xmyoot/guarded-ph-acquisition-module/docs/architecture/06_sources.md

# Sources and evidence

Manufacturer documents were checked on 20 October 2026. PDFs successfully retrieved are stored in `../../datasheets/`; `sources.json` records their URLs and SHA-256 hashes. Text files beside the PDFs are reading aids generated by `pdftotext`, not replacements for package figures.

| Source | Revision reviewed | Design use |
|---|---|---|
| [TI LMP91200](https://www.ti.com/lit/ds/symlink/lmp91200.pdf) | SNAS571E, February 2016; package addendum October 2025 | p.3 pin table; pp.5–7 electrical limits; p.14 buffer blocks; pp.15–17 electrode connection, decoupling and guard layout |
| [TI ADS112C04](https://www.ti.com/lit/ds/symlink/ads112c04.pdf) | SBAS894A, October 2018; retrieved package addendum 2026 | p.3 PW pin table; pp.23–25 gain implementation, Eq.6/7, reference; p.35 address; pp.38–45 protocol/registers |
| [TI REF32xx / REF3220](https://www.ti.com/lit/gpn/REF3220) | SBVS058D, April 2026 | p.3 pin functions; pp.4–6 accuracy/headroom/enable; pp.11–12 slow startup; force/sense section |
| [TI TPS7A20](https://www.ti.com/lit/ds/symlink/tps7a20.pdf) | SBVS338H, July 2024 | p.4 DBV pin table; electrical/capacitance requirements; orderable addendum identifies TPS7A2033PDBVR as DBV SOT-23-5 |
| [TI TPS383x](https://www.ti.com/lit/ds/symlink/tps3839.pdf) | SBVS193D, July 2015 | DBZ SOT-23-3 pin table; K33 threshold/drive and reset delay |
| [TI ISO154x](https://www.ti.com/lit/ds/symlink/iso1540.pdf) | SLLSEB6F, December 2022 | Candidate isolated I²C architecture, side-specific low-level compatibility and independent supplies |
| [ADI ADuM5401 family](https://www.analog.com/media/en/technical-documentation/data-sheets/adum5401_5402_5403_5404.pdf) | Rev E, June 2020, accessed through web | Existing chip's isolated-power and directed digital-channel function |

ADuM5401 PDF local download timed out; its source was inspected on the web but is **not** in the local hash manifest. The original AD7793 circuit was not reverse-engineered because it was not provided. No assertion about its real pinout, supply or board layout is based solely on its part number.

Manufacturer package addenda can change independently of the main electrical revision. Recheck lifecycle, exact orderable suffixes and stock when freezing the BOM. A listed active part is not a stock or delivery-time guarantee.

## Local input evidence

- `client_request/IMG_7255.PNG`: project context, legacy parts, promised schematic, unchanged remaining board.
- `client_request/IMG_7256.PNG`: existing system blocks, new three-IC chain, guarding/I²C and integration scope.
- `client_request/IMG_7257.PNG`: power/reference/noise checks, ERC/DRC, Altium and production deliverables.
- `client_request/IMG_7258.PNG`: duplicate experience requirements and job-advertisement terms.

No source PCB photograph, Altium project, actual circuit schematic, KiCad file, mechanical drawing or probe datasheet was present in the original input folder.

## Tool guidance

[kicad-happy](https://github.com/aklofas/kicad-happy) and [KiCadRoutingTools](https://github.com/drandyhaas/KiCadRoutingTools) informed implementation and review. Exact revisions and final use are recorded in [tool provenance](../implementation/tools.md). Tool support has not been equated with hardware qualification.

Additional mechanical references: [Amphenol 031-5431-1010](https://www.amphenolrf.com/en-us/part/031-5431-1010/1896/), drawing Rev E; [JST PH series](https://www.jst.com/wp-content/uploads/2021/08/ePH-new.pdf). Third-party PDFs remain local and can be retrieved from manufacturer sources.
