xmyoot/guarded-ph-acquisition-module/output/review/gerber-bottom.png

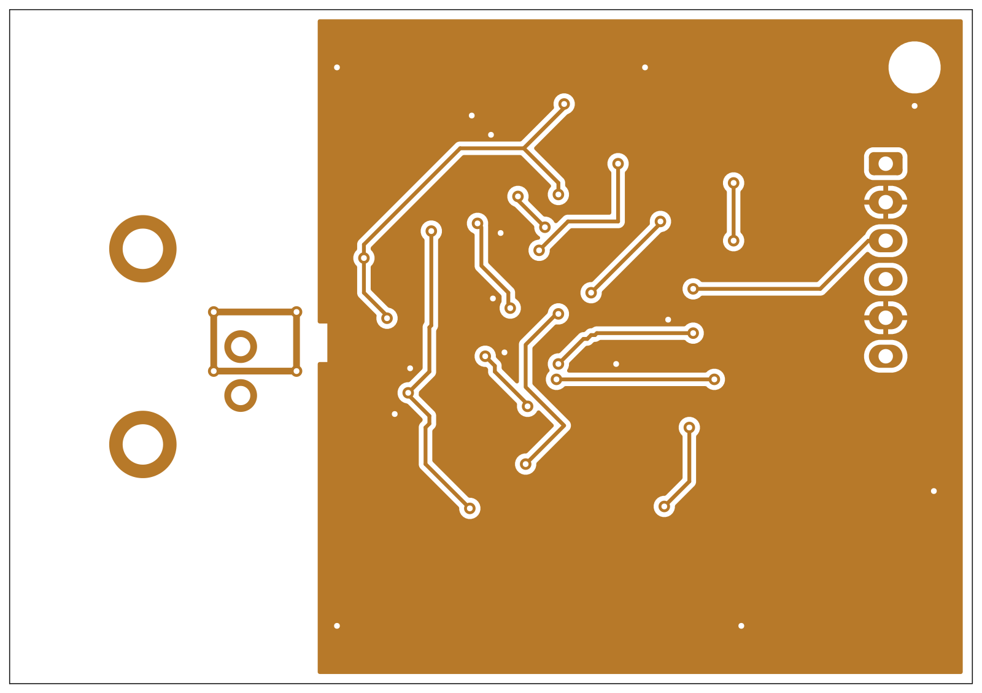
output/review/gerber-bottom.png
