xmyoot/guarded-ph-acquisition-module/output/review/gerber-top.png

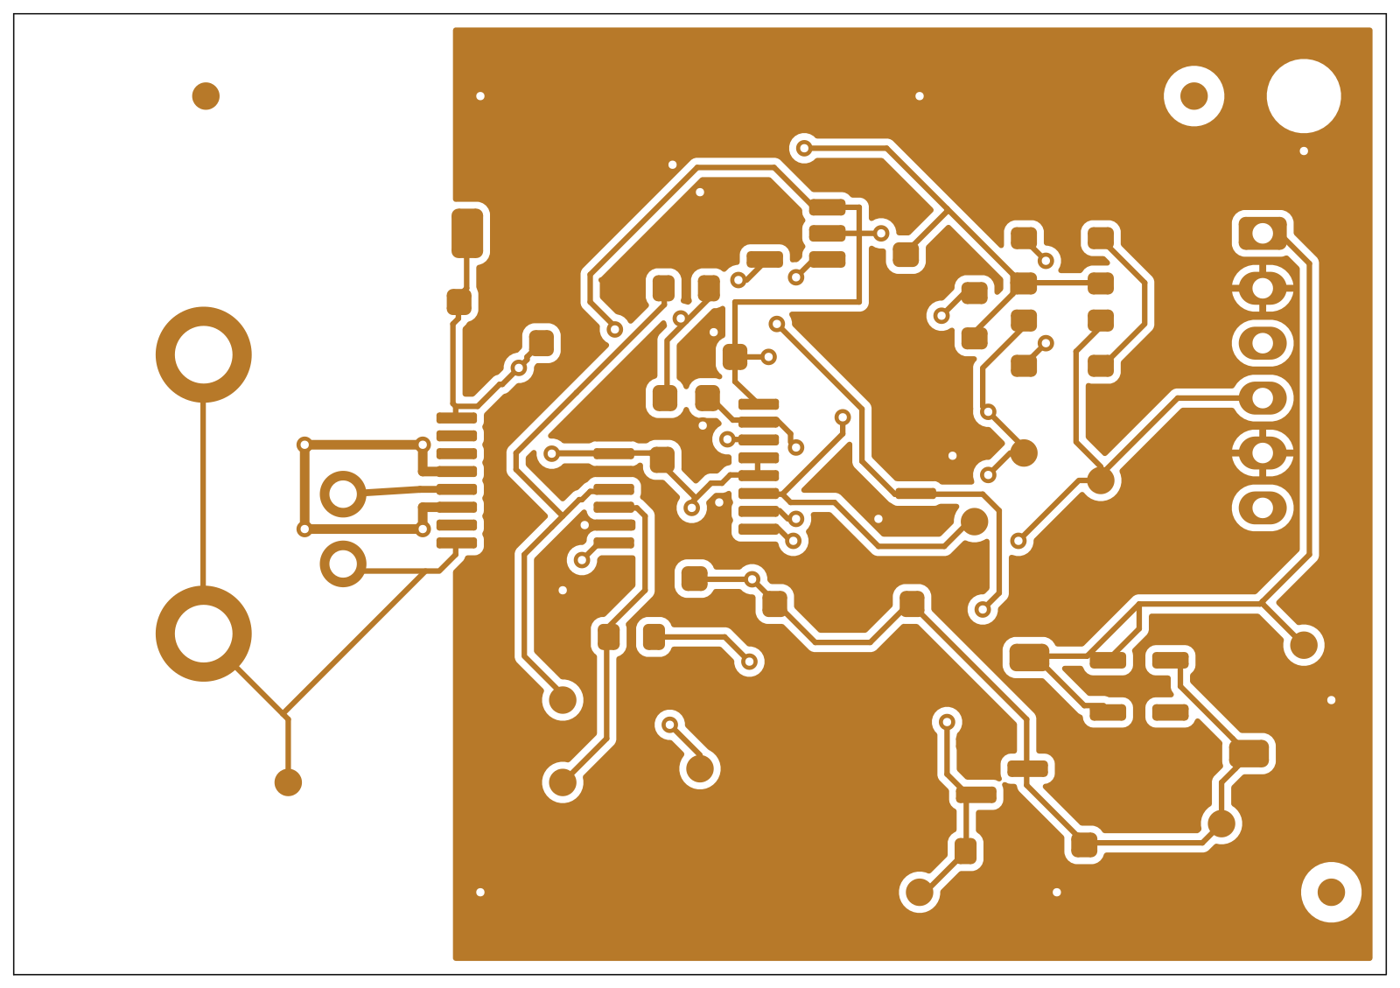
output/review/gerber-top.png
