xmyoot/guarded-ph-acquisition-module/docs/architecture/preliminary_bom.csv

Item | Quantity | Function | Candidate_MPN | Package_or_requirement | Population | Status | Notes
U1 | 1 | pH buffer | LMP91200MTX/NOPB | TSSOP-16 PW | Fit | Candidate | MT/NOPB obsolete in manufacturer addendum; confirm exact active orderable and stock
U2 | 1 | Differential ADC | ADS112C04IPWR | TSSOP-16 PW | Fit | Candidate | Use PW pin map; no QFN thermal pad
U3 | 1 | 2.048 V reference | REF3220AIDBVT | SOT-23-6 DBV | Fit | Candidate | Force and sense connections required
U4 | 1 | 3.3 V LDO | TPS7A2033PDBVR | SOT-23-5 DBV | Fit | Candidate | Do not substitute DQN pin mapping
U5 | 1 | Supply supervisor | TPS3839K33DBZT | SOT-23-3 DBZ | Fit | Candidate | 2.93 V nominal threshold; delayed push-pull reset
J1 | 1 | Probe connector | TBD | Insulated right-angle PCB BNC | Fit | Open | Shell is PH_VCM; exact drawing and low-leakage construction required
J2 | 1 | Host power and I2C | TBD | Keyed 6-position connector | Fit | Open | Pin plan in architecture; exact mating part required
RF_P RF_N | 2 | ADC series filter | TBD | 1 kohm 0.1% 25ppm/C 0603 | Fit | Value planned | Matched pair; no resistor on PH_IN
CF_DIFF | 1 | ADC differential filter | TBD | 10 nF C0G 25V or greater 0603/0805 | Fit | Value planned | Nominal differential pole 7.96 kHz
CF_CM_P CF_CM_N | 2 | Optional RF common-mode filter | TBD | 470 pF C0G matched 0603 | DNP | Experiment only | Populate only after interference and stability characterization
R_SDA R_SCL | 2 | I2C pullup | TBD | 4.7 kohm 1% 0603 | Fit | Value planned | Each through disconnectable link; account for host pullups
R_DRDY | 1 | Data ready pullup | TBD | 10 kohm 1% 0603 | Fit | Value planned | Local test point only
R_READY | 1 | Early-ramp pulldown | TBD | 100 kohm 1% 0603 | Fit | Value planned | Verify supervisor and reference startup sequence
JP_SDA JP_SCL | 2 | Pullup disconnect | TBD | Two-pad solder link default closed | Fit | Layout item | Alternative populated 0 ohm link if assembly prefers
C_U1_BULK | 1 | AFE bulk | TBD | 10 uF X7R 10V 0805 or larger | Fit | Value planned | Effective-capacitance check
C_U1_MID | 1 | AFE midband bypass | TBD | 1 uF X7R 10V 0603 | Fit | Value planned | At U1 supply pin 1
C_U1_HF | 2 | AFE supply bypass | TBD | 100 nF X7R 10V 0603 | Fit | Value planned | One at each U1 supply pin
C_U2_HF | 2 | ADC supply bypass | TBD | 100 nF X7R 10V 0603 | Fit | Value planned | Separate AVDD and DVDD placement
C_U2_BULK | 1 | ADC local bulk | TBD | 1 uF X7R 10V 0603 | Fit | Value planned | Quiet analog region
C_U3_IN | 1 | Reference input bypass | TBD | 100 nF X7R 10V 0603 | Fit | Value planned | At U3 input
C_U3_OUT | 1 | Reference output bypass | TBD | 1 uF X7R 10V 0603 | Fit | Value planned | At ADC REFP/REFN sense point; settling must be measured
C_U4_IN C_U4_OUT | 2 | LDO bypass | TBD | 4.7 uF X7R 10V 0805 | Fit | Value planned | Effective output capacitance >=1 uF; verify curves
C_U5 | 1 | Supervisor bypass | TBD | 100 nF X7R 10V 0603 | Fit | Value planned | At supervisor
TP_SET | 11 | Low-impedance test points | TBD | PCB pads with labeled ground clips | Fit | Layout item | No PH_IN test-point branch
ISO_CANDIDATE | 1 | Retrofit I2C isolation | ISO1540DR | SOIC-8 | Not on bench core | Conditional | Side1 to ADC; threshold and power-domain checks required
ISO_POWER | 1 | Retrofit isolated power | TBD | Qualified existing rail or selected isolated converter | Not on bench core | Open | 5V isolated preferred before LDO; do not invent existing rail
INPUT_PROTECTION | 1 | Field ESD and surge protection | TBD | Leakage-qualified architecture | Not on bench core | Open | No generic TVS on PH_IN; field release blocker
