xmyoot/guarded-ph-acquisition-module/output/assembly/BOM.csv

References | Quantity | Value | Manufacturer | MPN | Footprint | Population | Notes
U1 | 1 | LMP91200 | Texas Instruments | LMP91200MTX/NOPB | Soil_pH:TSSOP-16_4.4x5mm_P0.65mm | FIT
U2 | 1 | ADS112C04 | Texas Instruments | ADS112C04IPWR | Soil_pH:TSSOP-16_4.4x5mm_P0.65mm | FIT
U3 | 1 | REF3220 / 2.048V | Texas Instruments | REF3220AIDBVT | Soil_pH:SOT-23-6 | FIT
U4 | 1 | TPS7A2033 / 3.3V | Texas Instruments | TPS7A2033PDBVR | Soil_pH:SOT-23-5 | FIT
U5 | 1 | TPS3839K33 / 2.93V | Texas Instruments | TPS3839K33DBZT | Soil_pH:SOT-23 | FIT
J1 | 1 | INSULATED BNC | Amphenol RF | 031-5431-1010 | Soil_pH:BNC_031-5431-1010 | FIT
J2 | 1 | HOST / JST PH6 | JST | B6B-PH-K-S(LF)(SN) | Soil_pH:JST_PH_B6B-PH-K_1x06_P2.00mm_Vertical | FIT
R1,R2 | 2 | 1k | Vishay | TNPW06031K00BEEA | Soil_pH:R_0603_1608Metric | FIT | 0.1%,25ppm/K
R3,R4 | 2 | 4.7k | Vishay | CRCW06034K70FKEA | Soil_pH:R_0603_1608Metric | FIT | 1%
R5,R6 | 2 | 0R | Vishay | CRCW06030000Z0EA | Soil_pH:R_0603_1608Metric | FIT | jumper; remove R5/R6 to disable local bus pullups
R7 | 1 | 10k | Vishay | CRCW060310K0FKEA | Soil_pH:R_0603_1608Metric | FIT | 1%
R8 | 1 | 100k | Vishay | CRCW0603100KFKEA | Soil_pH:R_0603_1608Metric | FIT | 1%
C1 | 1 | 10u | Murata | GRM31CR71C106KA12L | Soil_pH:C_1206_3216Metric | FIT | X7R,16V,10%
C2,C7,C11 | 3 | 1u | Murata | GRM188R71C105KA12D | Soil_pH:C_0603_1608Metric | FIT | X7R,16V,10%
C3,C4,C5,C6,C8,C12 | 6 | 100n | Murata | GRM188R71H104KA93D | Soil_pH:C_0603_1608Metric | FIT | X7R,50V,10%
C9,C10 | 2 | 4.7u | Murata | GRM21BR71E475KA73L | Soil_pH:C_0805_2012Metric | FIT | X7R,25V,10%
C13 | 1 | 10n C0G | Murata | GRM1885C1H103JA01D | Soil_pH:C_0603_1608Metric | FIT | C0G,50V,5%
