xmyoot/guarded-ph-acquisition-module/output/assembly/assembly_top.pdf

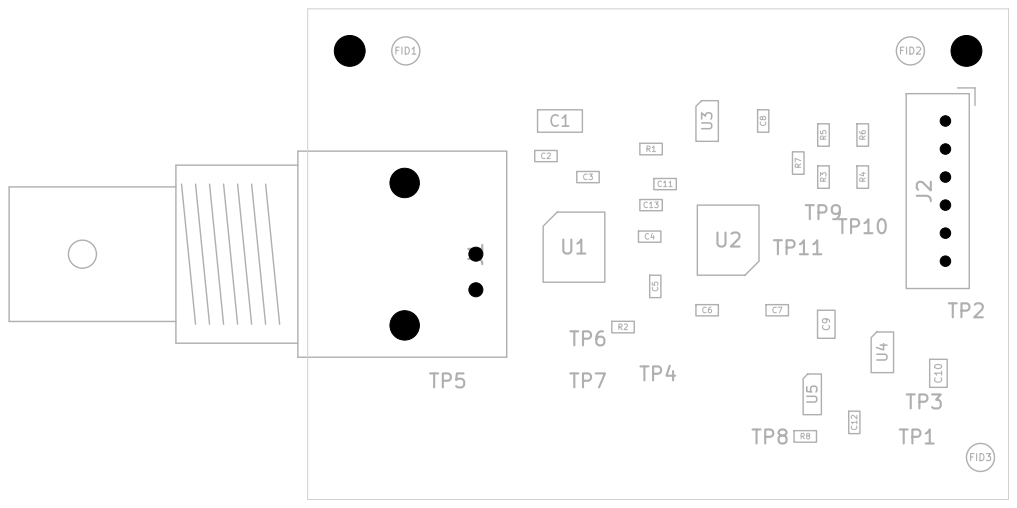
[picture p4: page 1]

Size: A4 | Rev:
KiCad E.D.A. 10.0.7 | Id: 1/1
