xmyoot/guarded-ph-acquisition-module/output/review/schematic.pdf

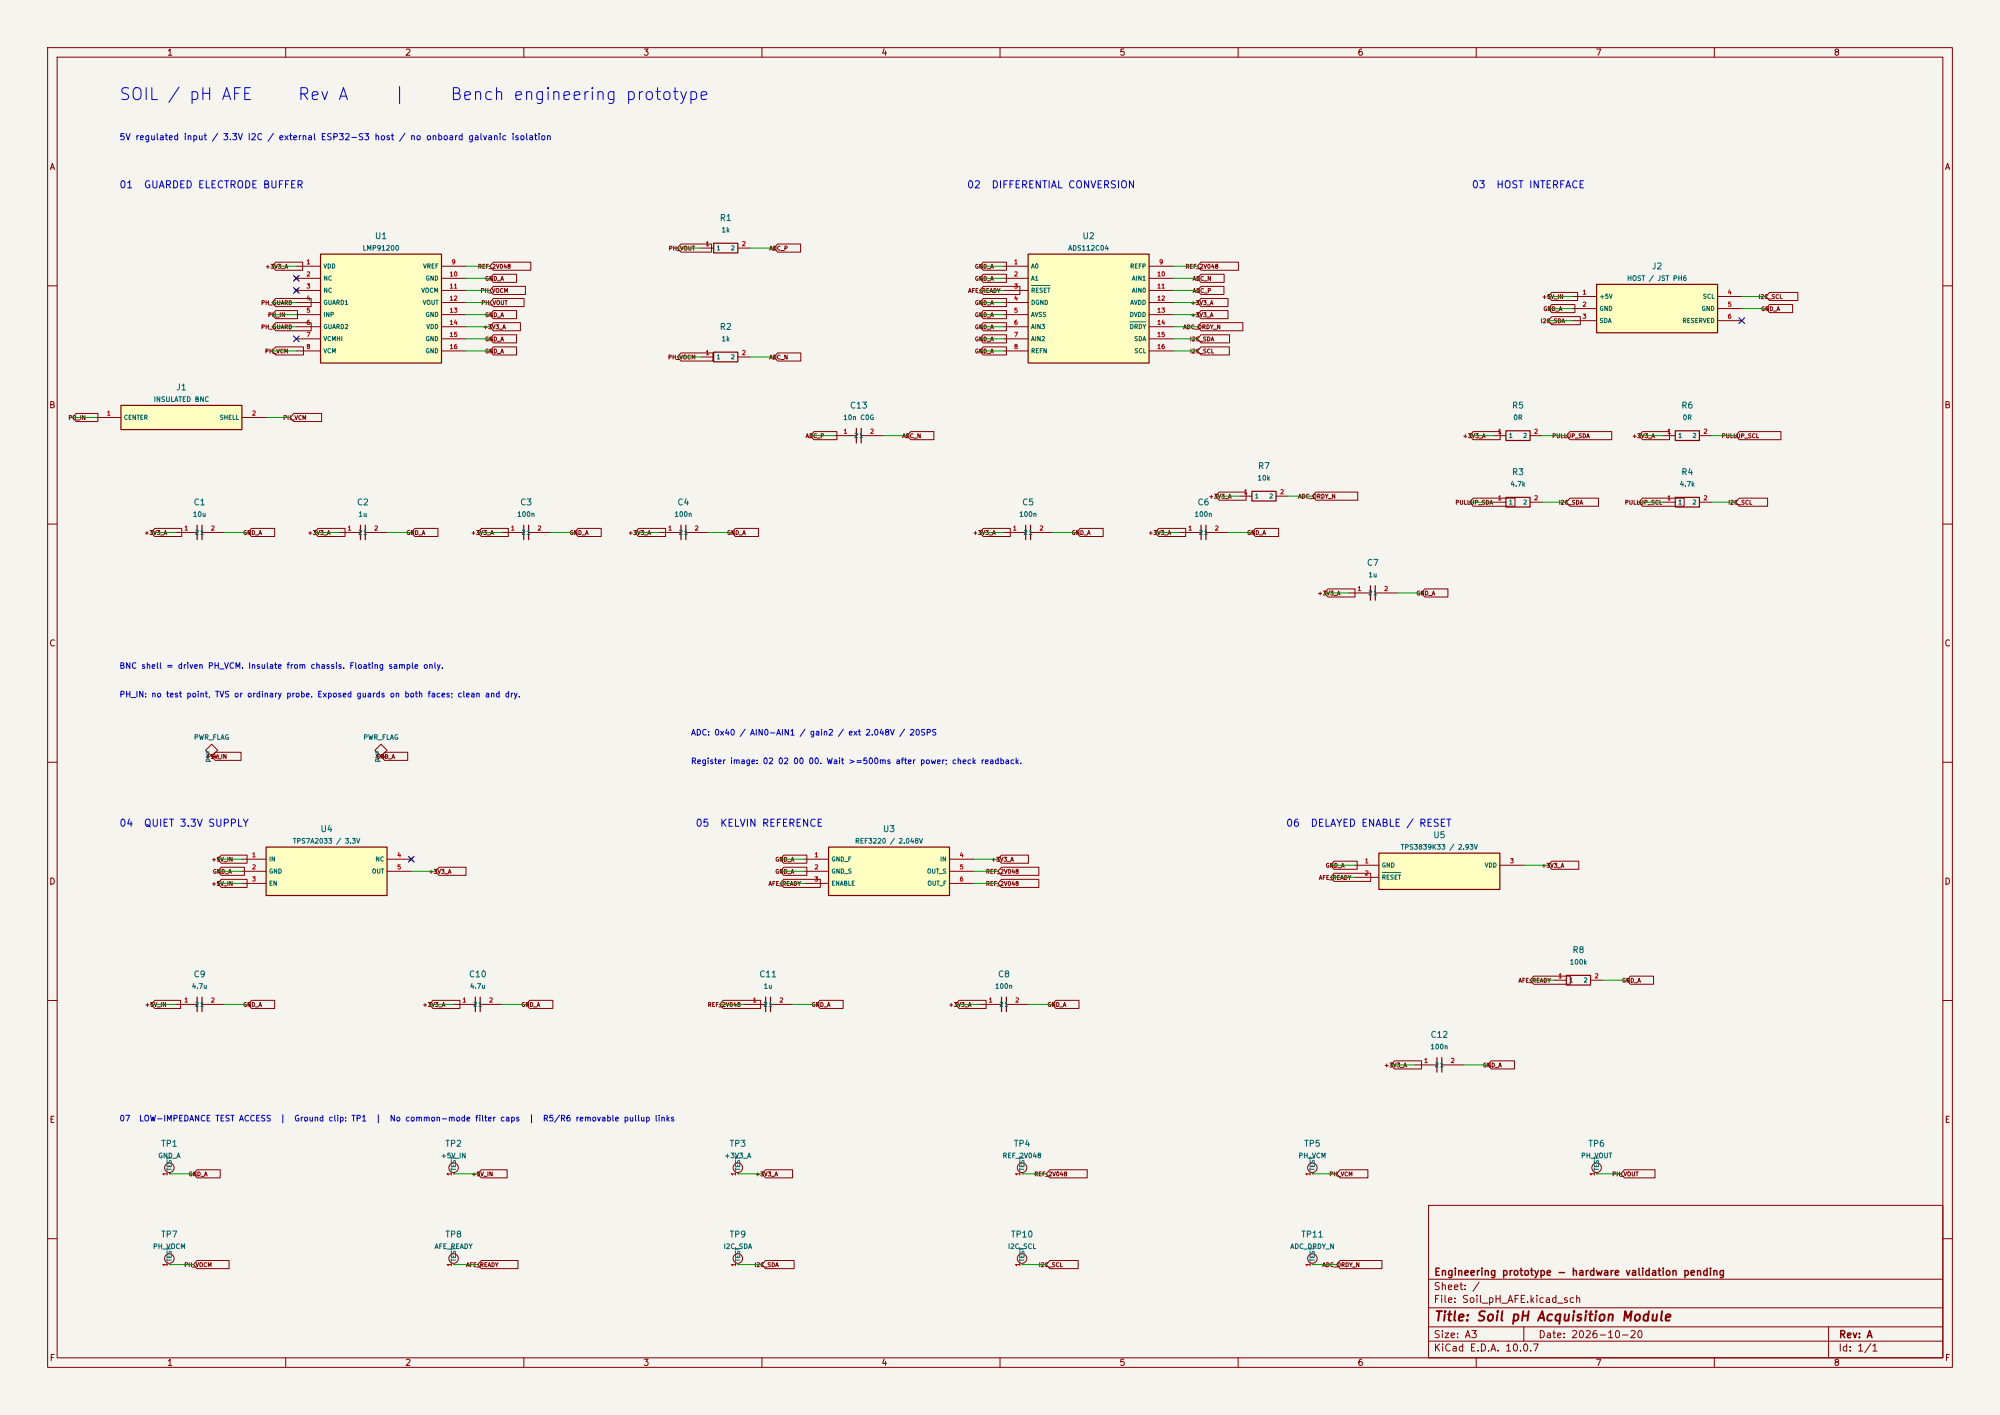
[picture p5: page 1]

5V regulated input / 3.3V I2C / external ESP32-S3 host / no onboard galvanic isolation 01 GUARDED ELECTRODE BUFFER

BNC shell = driven PH_VCM. Insulate from chassis. Floating sample only.

PH_IN: no test point, TVS or ordinary probe. Exposed guards on both faces; clean and dry.

07 LOW-IMPEDANCE TEST ACCESS | Ground clip: TP1 | No common-mode filter caps | R5/R6 removable pullup links
PH_VOCM TEST 1 TP1

Engineering prototype - hardware validation pending
Sheet: /
File: Soil_pH_AFE.kicad_sch
Title: Soil pH Acquisition Module

Size: A3 | Rev: A | F Date: 2026-10-20
KiCad E.D.A. 10.0.7 | Id: 1/1
