xmyoot/guarded-ph-acquisition-module/hardware/Soil_pH_AFE/Soil_pH_AFE.kicad_pcb

## KiCad design hardware/Soil_pH_AFE/Soil_pH_AFE.kicad_pcb (2026-10-21)

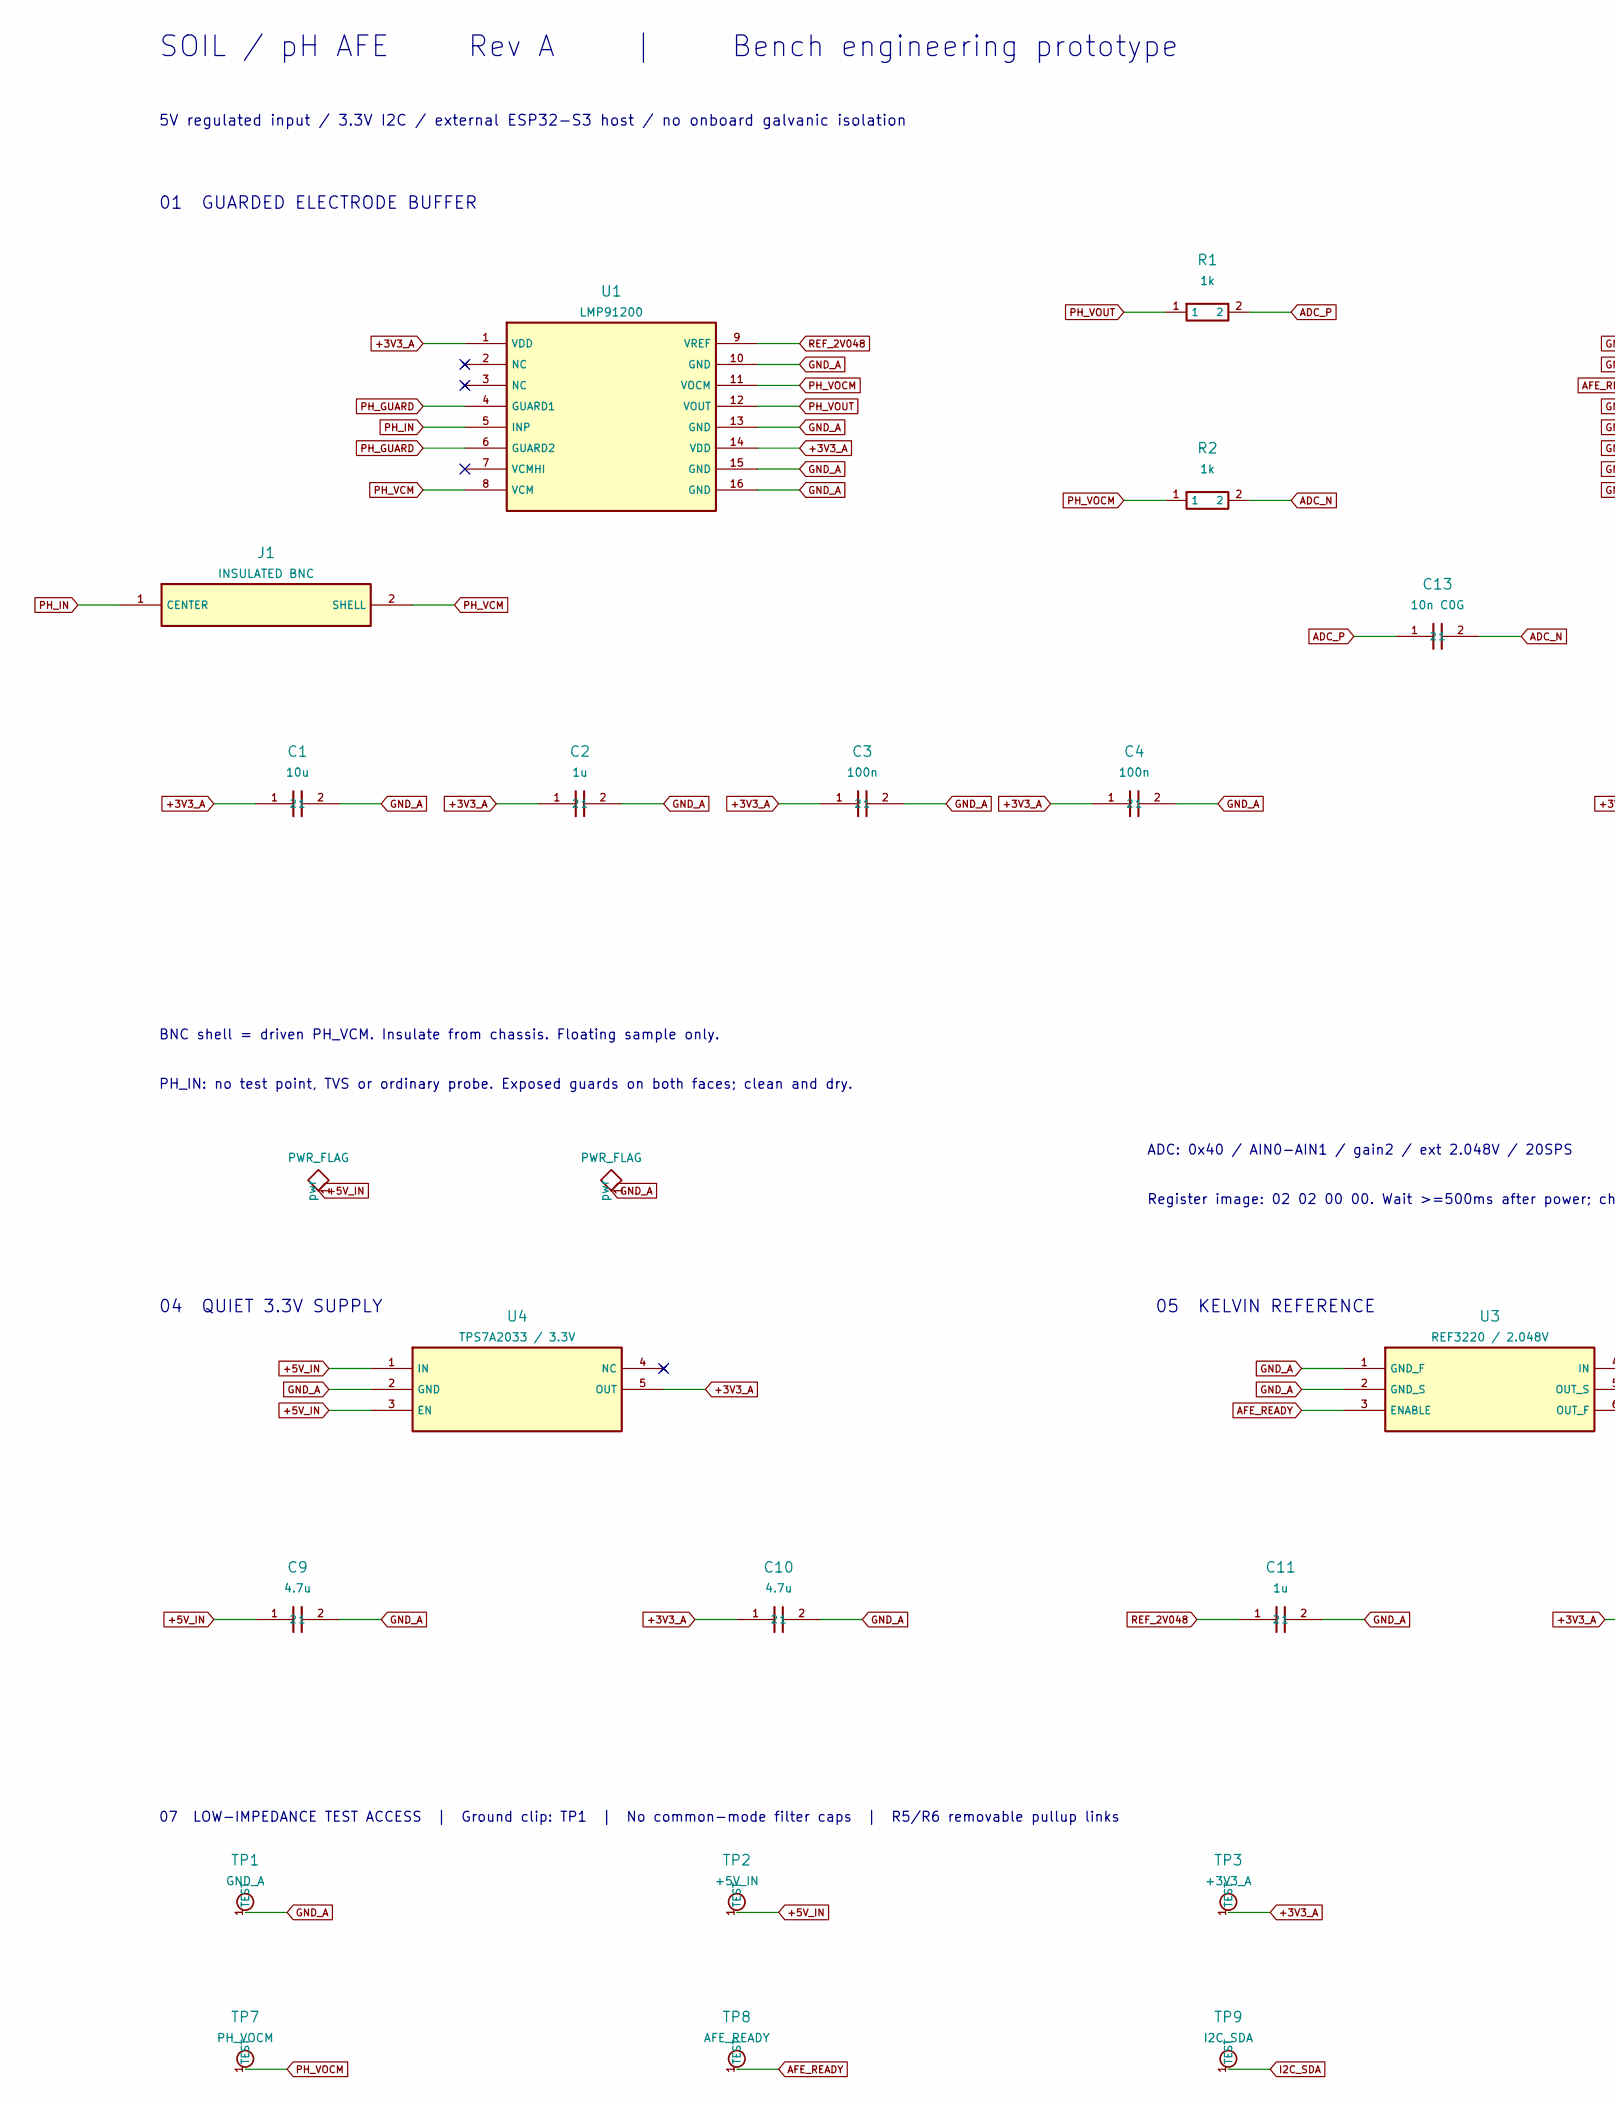
[picture p13: schematic Soil_pH_AFE.kicad_sch, Soil pH Acquisition Module, part in row 1, column 1]

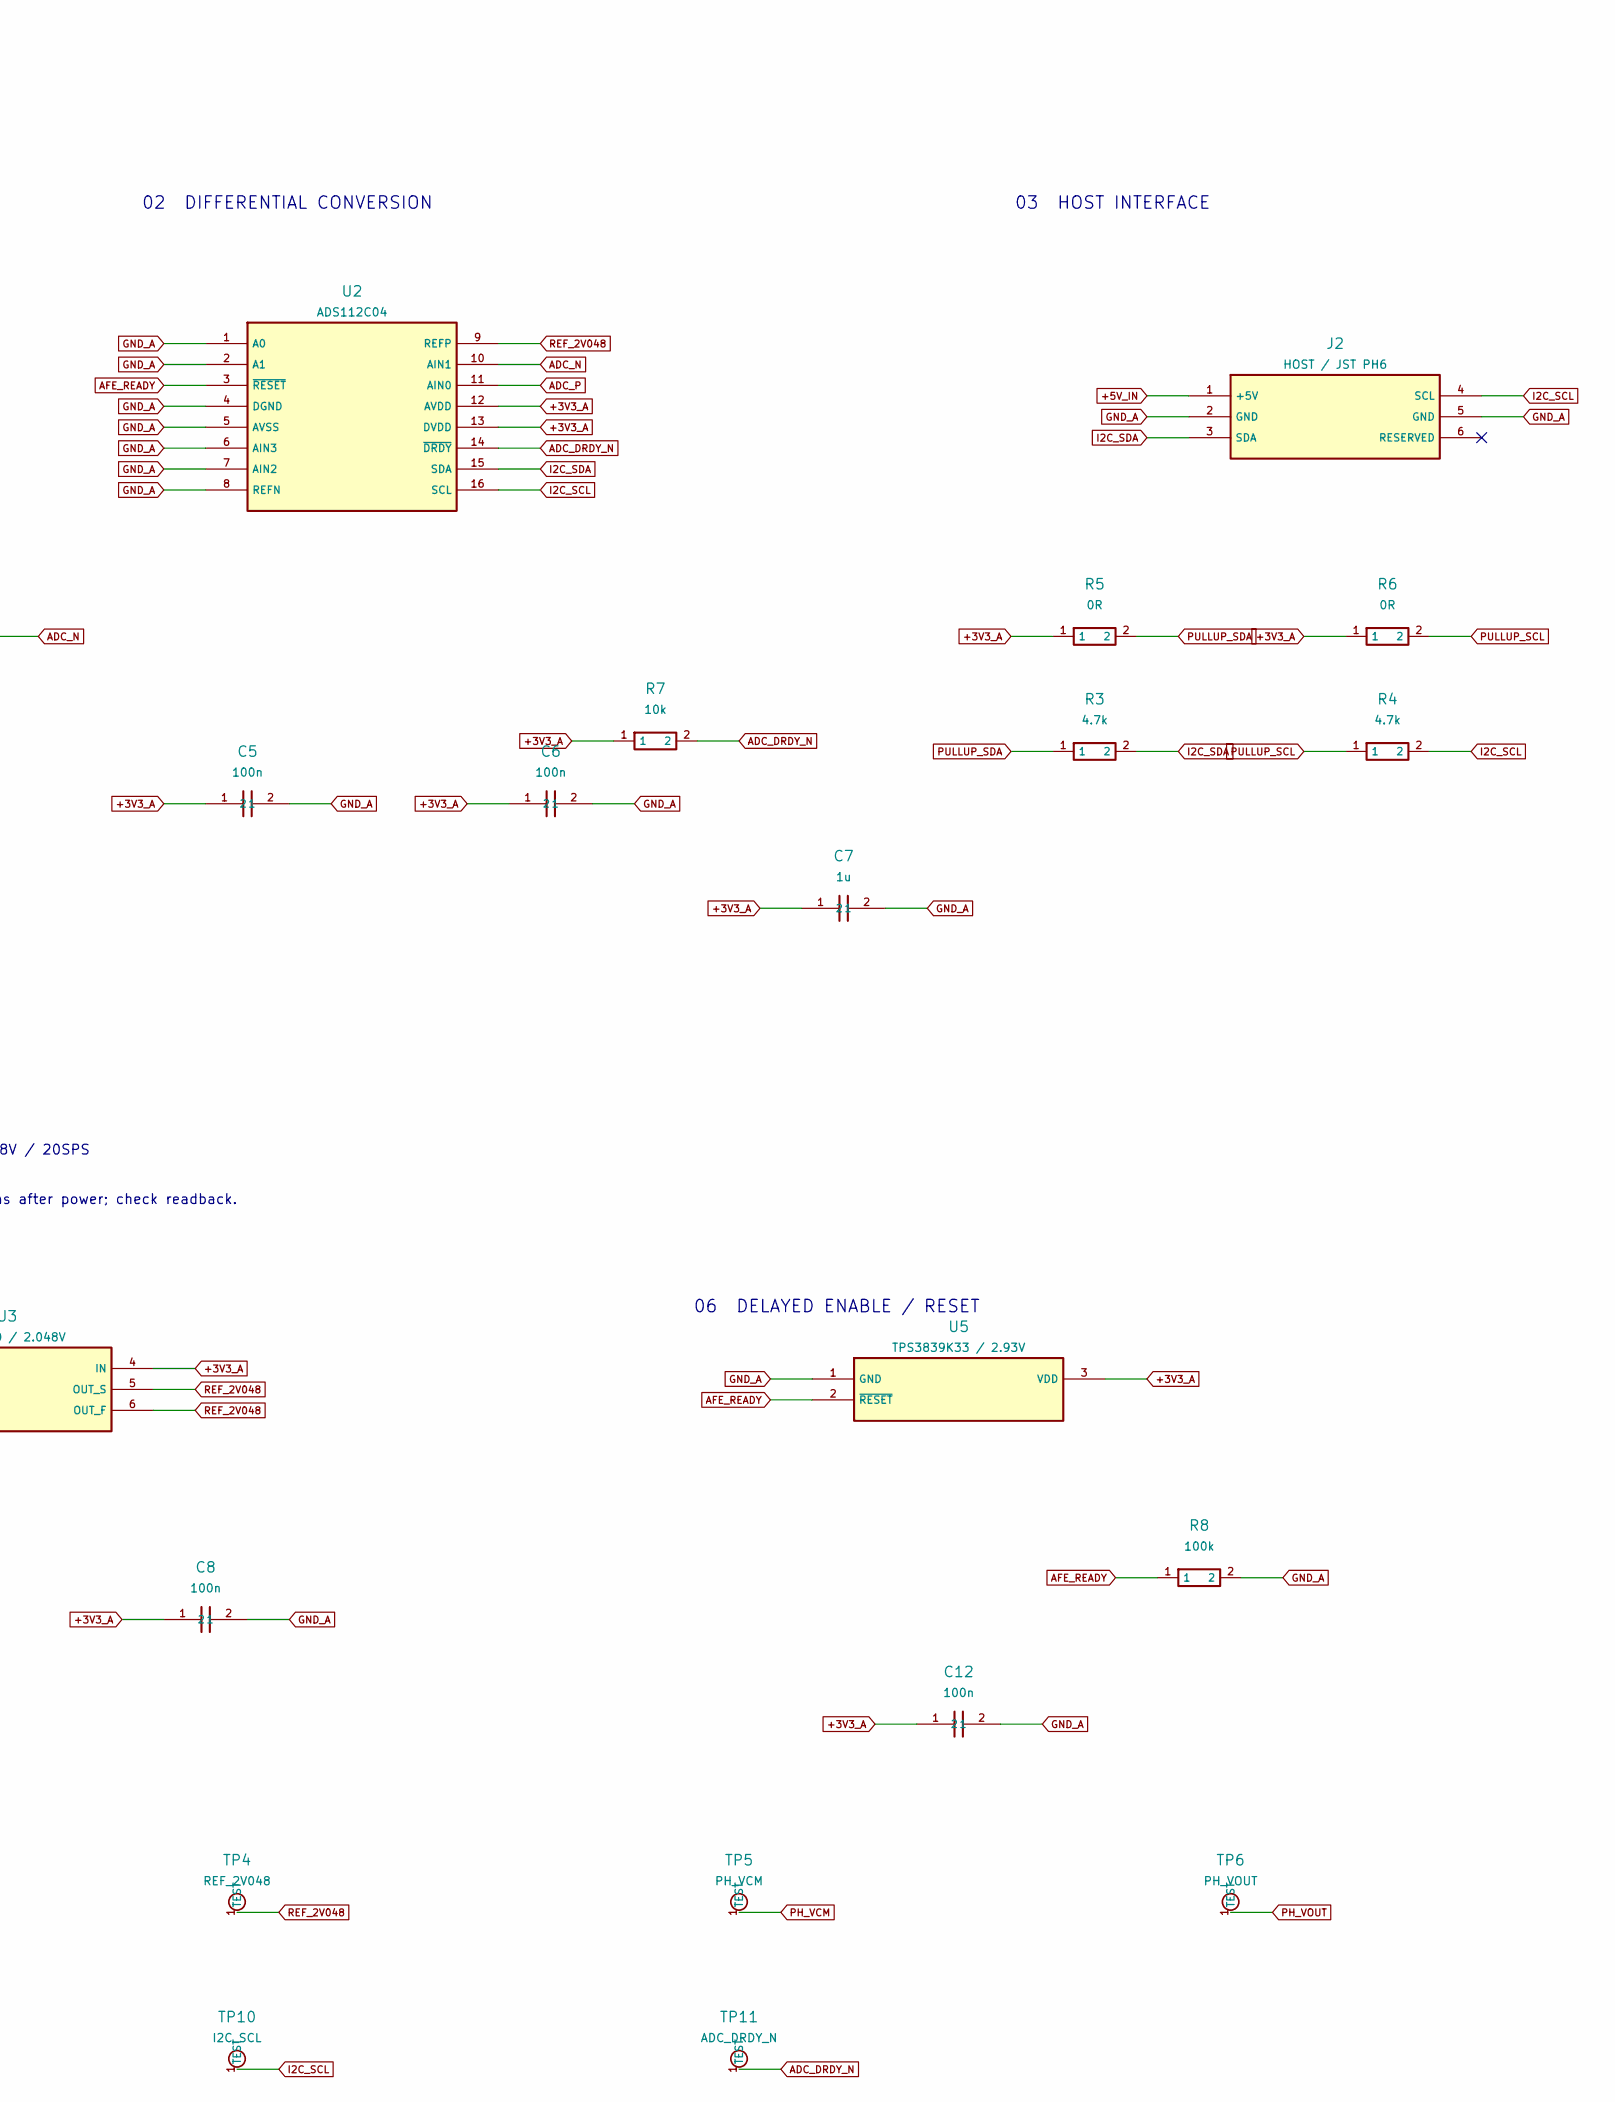
[picture p14: schematic Soil_pH_AFE.kicad_sch, Soil pH Acquisition Module, part in row 1, column 2]

Parts:
C1: 10u; C_1206_3216Metric; MPN GRM31CR71C106KA12L
C2, C7, C11: 1u; C_0603_1608Metric; MPN GRM188R71C105KA12D
C3, C4, C5, C6, C8, C12: 100n; C_0603_1608Metric; MPN GRM188R71H104KA93D
C9, C10: 4.7u; C_0805_2012Metric; MPN GRM21BR71E475KA73L
C13: 10n C0G; C_0603_1608Metric; MPN GRM1885C1H103JA01D
J1: INSULATED BNC; BNC_031-5431-1010; MPN 031-5431-1010
J2: HOST / JST PH6; JST_PH_B6B-PH-K_1x06_P2.00mm_Vertical; MPN B6B-PH-K-S(LF)(SN)
R1, R2: 1k; R_0603_1608Metric; MPN TNPW06031K00BEEA
R3, R4: 4.7k; R_0603_1608Metric; MPN CRCW06034K70FKEA
R5, R6: 0R; R_0603_1608Metric; MPN CRCW06030000Z0EA
R7: 10k; R_0603_1608Metric; MPN CRCW060310K0FKEA
R8: 100k; R_0603_1608Metric; MPN CRCW0603100KFKEA
TP1: GND_A; TestPoint_Pad_D1.0mm; MPN PCB_FEATURE
TP2: +5V_IN; TestPoint_Pad_D1.0mm; MPN PCB_FEATURE
TP3: +3V3_A; TestPoint_Pad_D1.0mm; MPN PCB_FEATURE
TP4: REF_2V048; TestPoint_Pad_D1.0mm; MPN PCB_FEATURE
TP5: PH_VCM; TestPoint_Pad_D1.0mm; MPN PCB_FEATURE
TP6: PH_VOUT; TestPoint_Pad_D1.0mm; MPN PCB_FEATURE
TP7: PH_VOCM; TestPoint_Pad_D1.0mm; MPN PCB_FEATURE
TP8: AFE_READY; TestPoint_Pad_D1.0mm; MPN PCB_FEATURE
TP9: I2C_SDA; TestPoint_Pad_D1.0mm; MPN PCB_FEATURE
TP10: I2C_SCL; TestPoint_Pad_D1.0mm; MPN PCB_FEATURE
TP11: ADC_DRDY_N; TestPoint_Pad_D1.0mm; MPN PCB_FEATURE
U1: LMP91200; TSSOP-16_4.4x5mm_P0.65mm; MPN LMP91200MTX/NOPB
U2: ADS112C04; TSSOP-16_4.4x5mm_P0.65mm; MPN ADS112C04IPWR
U3: REF3220 / 2.048V; SOT-23-6; MPN REF3220AIDBVT
U4: TPS7A2033 / 3.3V; SOT-23-5; MPN TPS7A2033PDBVR
U5: TPS3839K33 / 2.93V; SOT-23; MPN TPS3839K33DBZT

Connections:
+3V3_A: C1.1, C2.1, C3.1, C4.1, C5.1, C6.1, C7.1, C8.1, C10.1, C12.1, R5.1, R6.1, R7.1, TP3.1 (TEST_1), U1.1 (VDD), U1.14 (VDD), U2.12 (AVDD), U2.13 (DVDD), U3.4 (IN), U4.5 (OUT), U5.3 (VDD)
+5V_IN: C9.1, J2.1 (+5V), TP2.1 (TEST_1), U4.1 (IN), U4.3 (EN)
ADC_DRDY_N: R7.2, TP11.1 (TEST_1), U2.14 (~DRDY)
ADC_N: C13.2, R2.2, U2.10 (AIN1)
ADC_P: C13.1, R1.2, U2.11 (AIN0)
AFE_READY: R8.1, TP8.1 (TEST_1), U2.3 (~RESET), U3.3 (ENABLE), U5.2 (~RESET)
GND_A: C1.2, C2.2, C3.2, C4.2, C5.2, C6.2, C7.2, C8.2, C9.2, C10.2, C11.2, C12.2, J2.2 (GND), J2.5 (GND), R8.2, TP1.1 (TEST_1), U1.10 (GND), U1.13 (GND), U1.15 (GND), U1.16 (GND), U2.1 (A0), U2.2 (A1), U2.4 (DGND), U2.5 (AVSS), U2.6 (AIN3), U2.7 (AIN2), U2.8 (REFN), U3.1 (GND_F), U3.2 (GND_S), U4.2 (GND), U5.1 (GND)
I2C_SCL: J2.4 (SCL), R4.2, TP10.1 (TEST_1), U2.16 (SCL)
I2C_SDA: J2.3 (SDA), R3.2, TP9.1 (TEST_1), U2.15 (SDA)
PH_GUARD: U1.4 (GUARD1), U1.6 (GUARD2)
PH_IN: J1.1 (CENTER), U1.5 (INP)
PH_VCM: J1.2 (SHELL), TP5.1 (TEST_1), U1.8 (VCM)
PH_VOCM: R2.1, TP7.1 (TEST_1), U1.11 (VOCM)
PH_VOUT: R1.1, TP6.1 (TEST_1), U1.12 (VOUT)
PULLUP_SCL: R4.1, R6.2
PULLUP_SDA: R3.1, R5.2
REF_2V048: C11.1, TP4.1 (TEST_1), U1.9 (VREF), U2.9 (REFP), U3.5 (OUT_S), U3.6 (OUT_F)

Notes on the sheet:
SOIL / pH AFE Rev A | Bench engineering prototype
5V regulated input / 3.3V I2C / external ESP32-S3 host / no onboard galvanic isolation
01 GUARDED ELECTRODE BUFFER
02 DIFFERENTIAL CONVERSION
03 HOST INTERFACE
BNC shell = driven PH_VCM. Insulate from chassis. Floating sample only.
PH_IN: no test point, TVS or ordinary probe. Exposed guards on both faces; clean and dry.
04 QUIET 3.3V SUPPLY
05 KELVIN REFERENCE
06 DELAYED ENABLE / RESET
07 LOW-IMPEDANCE TEST ACCESS | Ground clip: TP1 | No common-mode filter caps | R5/R6 removable pullup links
ADC: 0x40 / AIN0-AIN1 / gain2 / ext 2.048V / 20SPS
Register image: 02 02 00 00. Wait >=500ms after power; check readback.

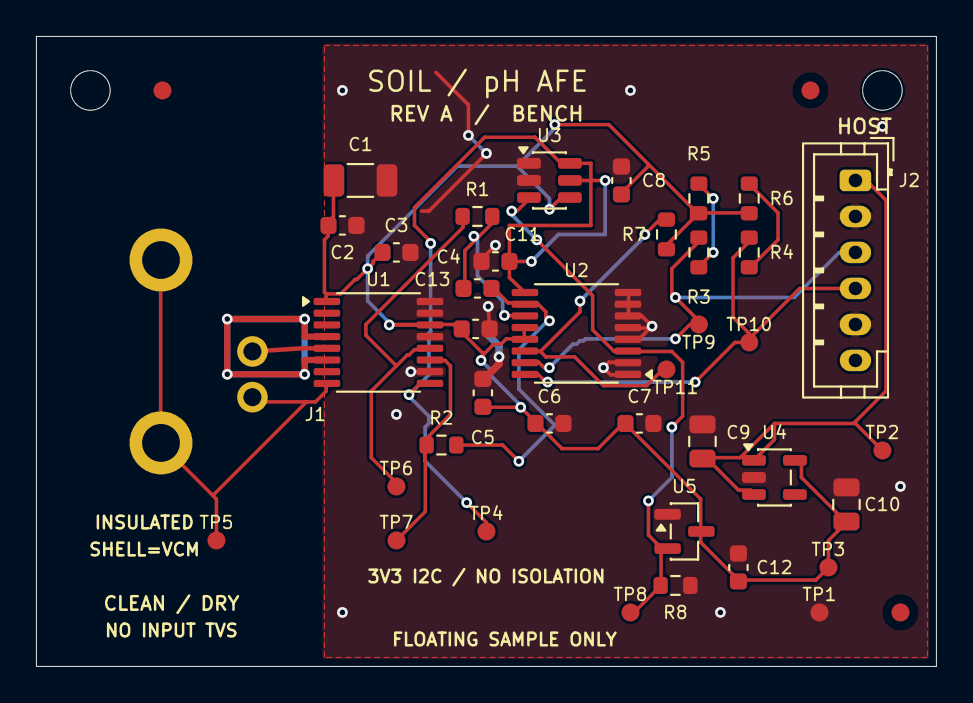
[picture p15: board Soil_pH_AFE.kicad_pcb from above]

Board: 2 copper layers, 50.0 x 35.0 mm, 44 parts (0 on the bottom side), 17 nets.

Other parts of the board:
FID1, FID2, FID3: OPTICAL; Fiducial_1mm_Mask2mm
H1, H2: M2 NPTH; MountingHole_2.2mm_M2
