xmyoot/guarded-ph-acquisition-module/(commit log)

2026-10-21 Publish reviewed Rev A guarded pH acquisition prototype
    [BOM.csv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]
2026-10-21 Simplify PCB routes and replace BNC box preview with detailed mesh
    [Soil_pH_AFE-B_Cu.gbl, Soil_pH_AFE-B_Mask.gbs, Soil_pH_AFE-B_Paste.gbp, Soil_pH_AFE-B_Silkscreen.gbo, Soil_pH_AFE-Edge_Cuts.gm1, Soil_pH_AFE-F_Cu.gtl, Soil_pH_AFE-F_Mask.gts, Soil_pH_AFE-F_Paste.gtp]
